jspolsky/Antenna2022/main/circuits/Receiver/receiver-1.0-bomandpos/Receiver-BOM.xlsx

Receiver-BOM
Comment | Designator | Footprint | Description | JLCPCB Part #
10uF | C1 C2 | 0805 | Unpolarized capacitor, small symbol | C15850
22uF | C3 | 0805 | Unpolarized capacitor, small symbol | C45783
0.1uF | C4 | 0402 | Unpolarized capacitor, small symbol | C1525
100uF 16V | C5 C6 C7 | 1210 | Unpolarized capacitor, small symbol | C90143
LED | D1 | 0805 | Light emitting diode | C84256
10K | R1 R2 R3 R5 | 0603 | Resistor, US symbol | C25804
1K | R4 | 0603 | Resistor, US symbol | C21190
20K | R6 R7 | 0603 | Resistor, US symbol | C4184
120 | R8 | 0603 | Resistor, US symbol | C22787
AMS1117-5.0 | U1 | SOT-223 | 1A Low Dropout regulator, positive, 5.0V fixed output, SOT-223 | C6187
MAX485E | U2 | SOIC-8 | Half duplex RS-485/RS-422, 2.5 Mbps, ±15kV electro-static discharge (ESD) protection, no slew-rate, no low-power shutdown, with receiver/driver enable, 32 receiver drive kapacitity, DIP-8 and SOIC-8 | C19738
