jspolsky/Antenna2022/main/circuits/CentralBrain/Printing Print.pdf

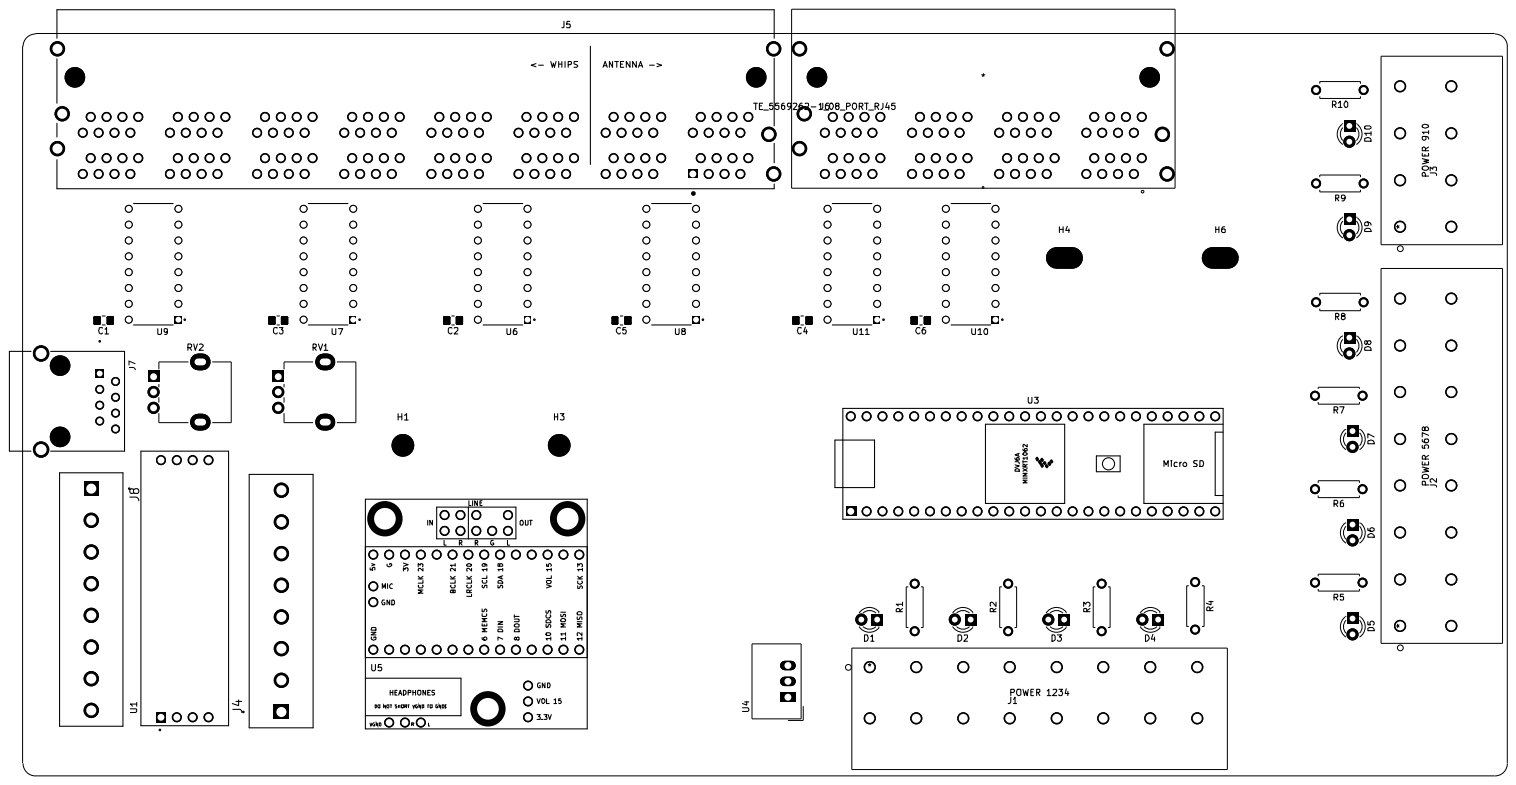
[picture p1: page 1]
