jspolsky/Antenna2022/main/circuits/CentralBrain/CentralBrain.kicad_pcb

## KiCad design main/circuits/CentralBrain/CentralBrain.kicad_pcb (2022-06-03)

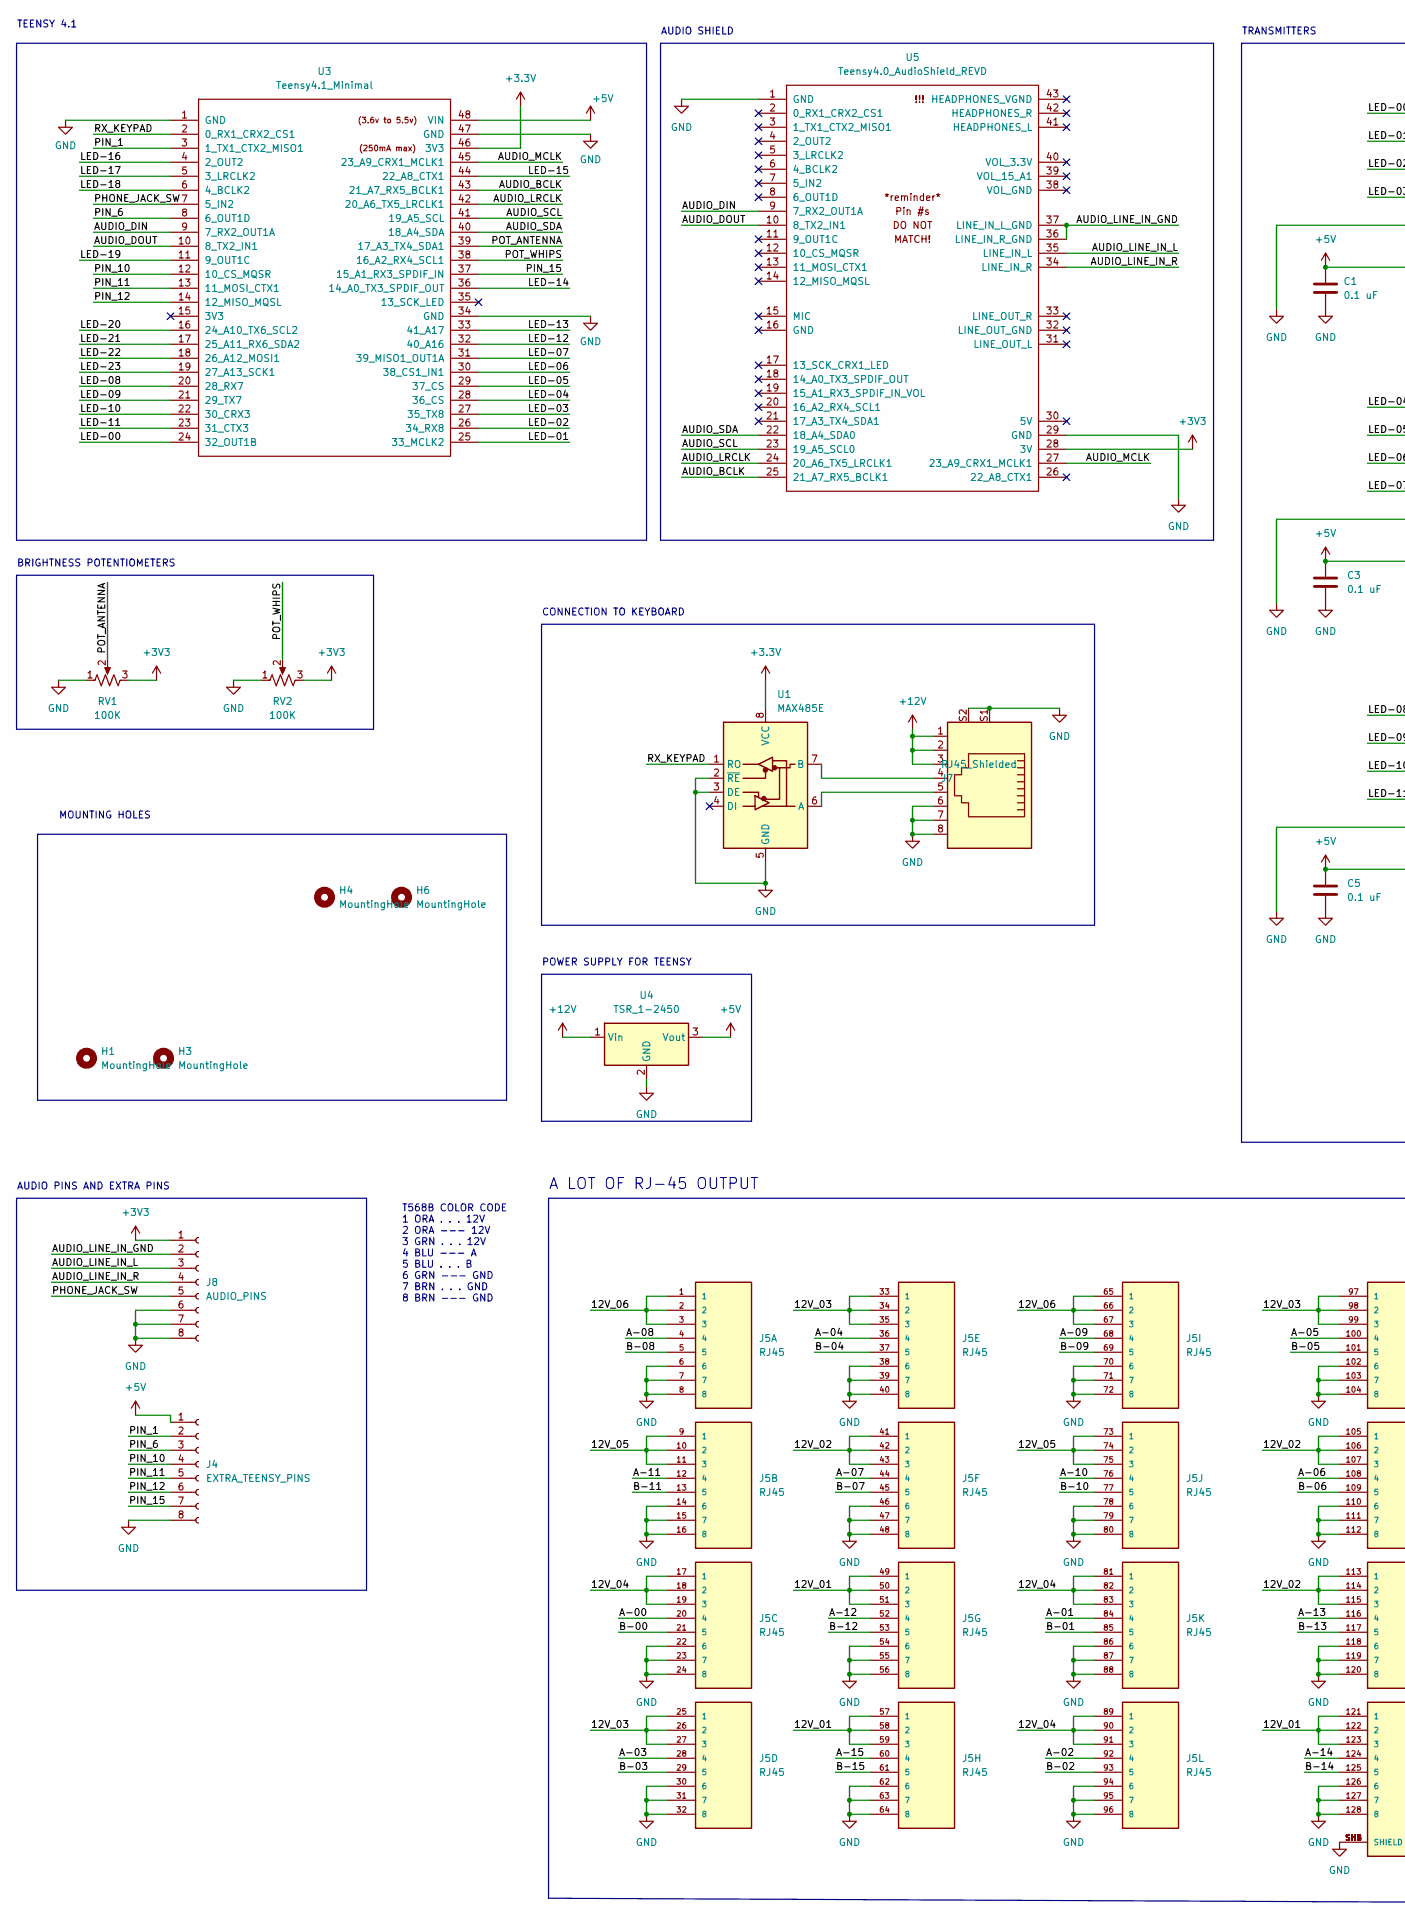
[picture p2: schematic CentralBrain.kicad_sch, part in row 1, column 1]

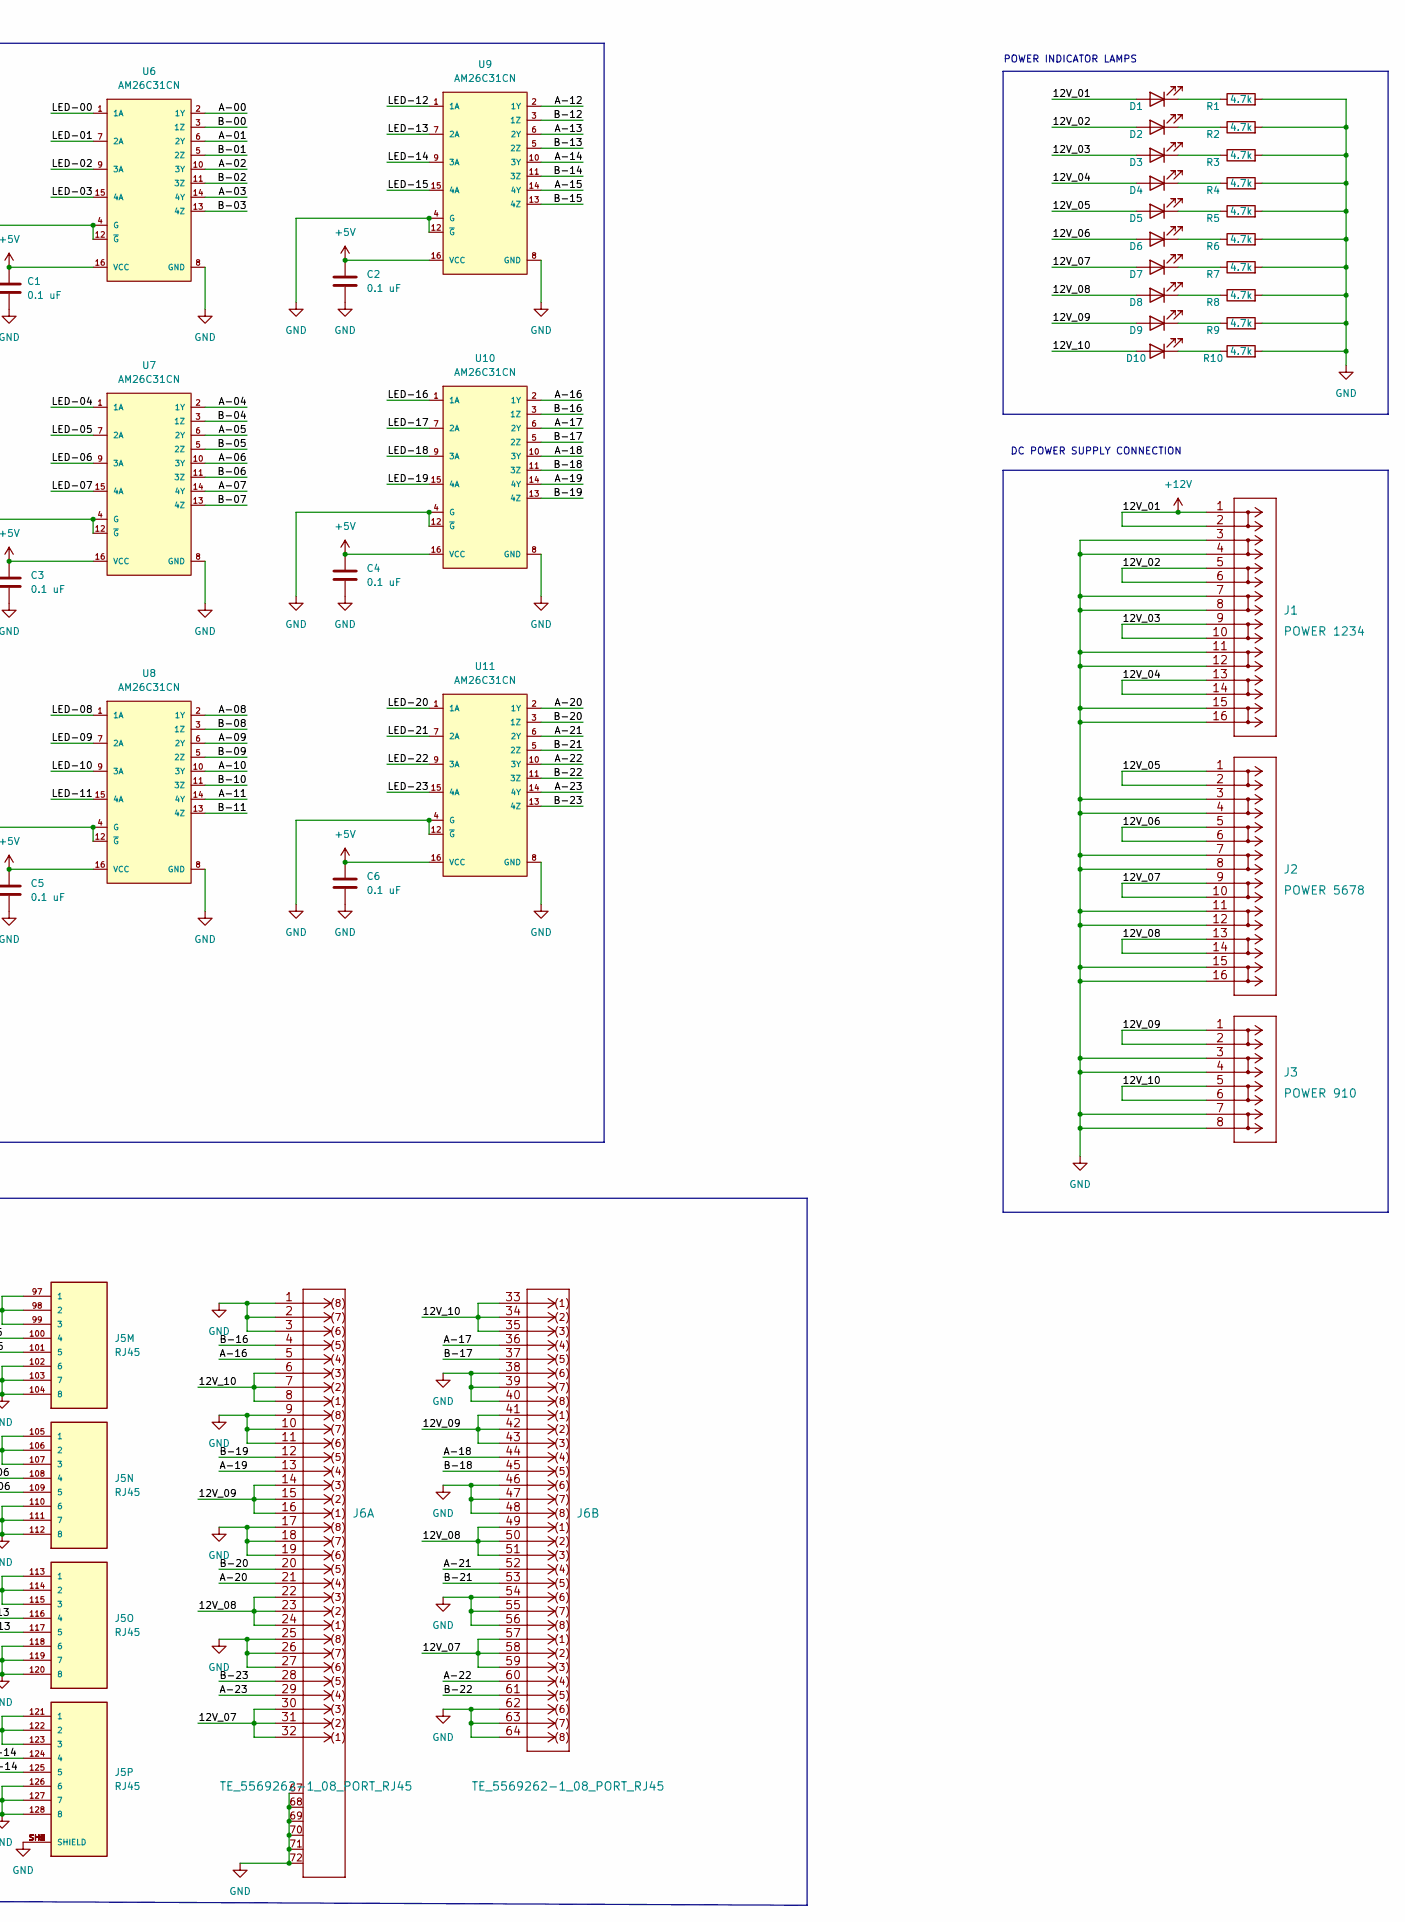
[picture p3: schematic CentralBrain.kicad_sch, part in row 1, column 2]

Parts:
C1, C2, C3, C4, C5, C6: 0.1 uF; C_0805_2012Metric_Pad1.18x1.45mm_HandSolder
D1, D2, D3, D4, D5, D6, D7, D8, D9, D10: LED; LED_D3.0mm
H1, H3, H4, H6: MountingHole; MountingHole_3.5mm
J1: POWER 1234; WAGO-2604-1308
J2: POWER 5678; WAGO-2604-1308
J3: POWER 910; WAGO-2604-1304
J4: EXTRA_TEENSY_PINS; CUI_term_block_8_TB004-508-08BE
J5: RJ45; TE_5569264-1_16_Port_RJ45
J6: TE_5569262-1_08_PORT_RJ45; TE_5569262-1_08_Port_RJ45
J7: RJ45_Shielded; RJ45-ASSMANN_A-2004-1-4-LP-N-R
J8: AUDIO_PINS; CUI_term_block_8_TB004-508-08BE
R1, R2, R3, R4, R5, R6, R7, R8, R9, R10: 4.7k; R_Axial_DIN0207_L6.3mm_D2.5mm_P7.62mm_Horizontal
RV1, RV2: 100K; Potentiometer_Alpha_RD901F-40-00D_Single_Vertical
U1: MAX485E; Max485-Module
U3: Teensy4.1_Minimal; Teensy41_Minimal
U4: TSR_1-2450; Converter_DCDC_TRACO_TSR-1_THT
U5: Teensy4.0_AudioShield_REVD; Teensy4.0_Audioshield_RevD
U6, U7, U8, U9, U10, U11: AM26C31CN; Rating Catalog; Supply VoltagesV 5

Connections:
+5V: C1.1, C2.1, C3.1, C4.1, C5.1, C6.1, J4.1, U3.48 (VIN), U4.3 (Vout), U6.16 (VCC), U7.16 (VCC), U8.16 (VCC), U9.16 (VCC), U10.16 (VCC), U11.16 (VCC)
+12V: D1.2 (A), J1.1, J1.2, J5.49 (1), J5.50 (2), J5.51 (3), J5.57 (1), J5.58 (2), J5.59 (3), J5.121 (1), J5.122 (2), J5.123 (3), J7.1, J7.2, J7.3, U4.1 (Vin)
/12V_02: D2.2 (A), J1.5, J1.6, J5.41 (1), J5.42 (2), J5.43 (3), J5.105 (1), J5.106 (2), J5.107 (3), J5.113 (1), J5.114 (2), J5.115 (3)
/12V_03: D3.2 (A), J1.9, J1.10, J5.25 (1), J5.26 (2), J5.27 (3), J5.33 (1), J5.34 (2), J5.35 (3), J5.97 (1), J5.98 (2), J5.99 (3)
/12V_04: D4.2 (A), J1.13, J1.14, J5.17 (1), J5.18 (2), J5.19 (3), J5.81 (1), J5.82 (2), J5.83 (3), J5.89 (1), J5.90 (2), J5.91 (3)
/12V_05: D5.2 (A), J2.1, J2.2, J5.9 (1), J5.10 (2), J5.11 (3), J5.73 (1), J5.74 (2), J5.75 (3)
/12V_06: D6.2 (A), J2.5, J2.6, J5.1, J5.2, J5.3, J5.65 (1), J5.66 (2), J5.67 (3)
/12V_07: D7.2 (A), J2.9, J2.10, J6.30, J6.31, J6.32, J6.57, J6.58, J6.59
/12V_08: D8.2 (A), J2.13, J2.14, J6.22, J6.23, J6.24, J6.49, J6.50, J6.51
/12V_09: D9.2 (A), J3.1, J3.2, J6.14, J6.15, J6.16, J6.41, J6.42, J6.43
/12V_10: D10.2 (A), J3.5, J3.6, J6.6, J6.7, J6.8, J6.33, J6.34, J6.35
/A-00: J5.20 (4), U6.2 (1Y)
/A-01: J5.84 (4), U6.6 (2Y)
/A-02: J5.92 (4), U6.10 (3Y)
/A-03: J5.28 (4), U6.14 (4Y)
/A-04: J5.36 (4), U7.2 (1Y)
/A-05: J5.100 (4), U7.6 (2Y)
/A-06: J5.108 (4), U7.10 (3Y)
/A-07: J5.44 (4), U7.14 (4Y)
/A-08: J5.4, U8.2 (1Y)
/A-09: J5.68 (4), U8.6 (2Y)
/A-10: J5.76 (4), U8.10 (3Y)
/A-11: J5.12 (4), U8.14 (4Y)
/A-12: J5.52 (4), U9.2 (1Y)
/A-13: J5.116 (4), U9.6 (2Y)
/A-14: J5.124 (4), U9.10 (3Y)
/A-15: J5.60 (4), U9.14 (4Y)
/A-16: J6.5, U10.2 (1Y)
/A-17: J6.36, U10.6 (2Y)
/A-18: J6.44, U10.10 (3Y)
/A-19: J6.13, U10.14 (4Y)
/A-20: J6.21, U11.2 (1Y)
/A-21: J6.52, U11.6 (2Y)
/A-22: J6.60, U11.10 (3Y)
/A-23: J6.29, U11.14 (4Y)
/AUDIO_BCLK: U3.43 (21_A7_RX5_BCLK1), U5.25 (21_A7_RX5_BCLK1)
/AUDIO_DIN: U3.9 (7_RX2_OUT1A), U5.9 (7_RX2_OUT1A)
/AUDIO_DOUT: U3.10 (8_TX2_IN1), U5.10 (8_TX2_IN1)
/AUDIO_LINE_IN_GND: J8.2, U5.36 (LINE_IN_R_GND), U5.37 (LINE_IN_L_GND)
/AUDIO_LINE_IN_L: J8.3, U5.35 (LINE_IN_L)
/AUDIO_LINE_IN_R: J8.4, U5.34 (LINE_IN_R)
/AUDIO_LRCLK: U3.42 (20_A6_TX5_LRCLK1), U5.24 (20_A6_TX5_LRCLK1)
/AUDIO_MCLK: U3.45 (23_A9_CRX1_MCLK1), U5.27 (23_A9_CRX1_MCLK1)
/AUDIO_SCL: U3.41 (19_A5_SCL), U5.23 (19_A5_SCL0)
/AUDIO_SDA: U3.40 (18_A4_SDA), U5.22 (18_A4_SDA0)
/B-00: J5.21 (5), U6.3 (1Z)
/B-01: J5.85 (5), U6.5 (2Z)
/B-02: J5.93 (5), U6.11 (3Z)
/B-03: J5.29 (5), U6.13 (4Z)
/B-04: J5.37 (5), U7.3 (1Z)
/B-05: J5.101 (5), U7.5 (2Z)
/B-06: J5.109 (5), U7.11 (3Z)
/B-07: J5.45 (5), U7.13 (4Z)
/B-08: J5.5, U8.3 (1Z)
/B-09: J5.69 (5), U8.5 (2Z)
/B-10: J5.77 (5), U8.11 (3Z)
/B-11: J5.13 (5), U8.13 (4Z)
/B-12: J5.53 (5), U9.3 (1Z)
/B-13: J5.117 (5), U9.5 (2Z)
/B-14: J5.125 (5), U9.11 (3Z)
/B-15: J5.61 (5), U9.13 (4Z)
/B-16: J6.4, U10.3 (1Z)
/B-17: J6.37, U10.5 (2Z)
/B-18: J6.45, U10.11 (3Z)
/B-19: J6.12, U10.13 (4Z)
/B-20: J6.20, U11.3 (1Z)
/B-21: J6.53, U11.5 (2Z)
/B-22: J6.61, U11.11 (3Z)
/B-23: J6.28, U11.13 (4Z)
/LED-00: U3.24 (32_OUT1B), U6.1 (1A)
/LED-01: U3.25 (33_MCLK2), U6.7 (2A)
/LED-02: U3.26 (34_RX8), U6.9 (3A)
/LED-03: U3.27 (35_TX8), U6.15 (4A)
/LED-04: U3.28 (36_CS), U7.1 (1A)
/LED-05: U3.29 (37_CS), U7.7 (2A)
/LED-06: U3.30 (38_CS1_IN1), U7.9 (3A)
/LED-07: U3.31 (39_MISO1_OUT1A), U7.15 (4A)
/LED-08: U3.20 (28_RX7), U8.1 (1A)
/LED-09: U3.21 (29_TX7), U8.7 (2A)
/LED-10: U3.22 (30_CRX3), U8.9 (3A)
/LED-11: U3.23 (31_CTX3), U8.15 (4A)
/LED-12: U3.32 (40_A16), U9.1 (1A)
/LED-13: U3.33 (41_A17), U9.7 (2A)
/LED-14: U3.36 (14_A0_TX3_SPDIF_OUT), U9.9 (3A)
/LED-15: U3.44 (22_A8_CTX1), U9.15 (4A)
/LED-16: U3.4 (2_OUT2), U10.1 (1A)
/LED-17: U3.5 (3_LRCLK2), U10.7 (2A)
/LED-18: U3.6 (4_BCLK2), U10.9 (3A)
/LED-19: U3.11 (9_OUT1C), U10.15 (4A)
/LED-20: U3.16 (24_A10_TX6_SCL2), U11.1 (1A)
/LED-21: U3.17 (25_A11_RX6_SDA2), U11.7 (2A)
/LED-22: U3.18 (26_A12_MOSI1), U11.9 (3A)
/LED-23: U3.19 (27_A13_SCK1), U11.15 (4A)
/PHONE_JACK_SW: J8.5, U3.7 (5_IN2)
/PIN_1: J4.2, U3.3 (1_TX1_CTX2_MISO1)
/PIN_6: J4.3, U3.8 (6_OUT1D)
/PIN_10: J4.4, U3.12 (10_CS_MQSR)
/PIN_11: J4.5, U3.13 (11_MOSI_CTX1)
/PIN_12: J4.6, U3.14 (12_MISO_MQSL)
/PIN_15: J4.7, U3.37 (15_A1_RX3_SPDIF_IN)
/POT_ANTENNA: RV1.2, U3.39 (17_A3_TX4_SDA1)
/POT_WHIPS: RV2.2, U3.38 (16_A2_RX4_SCL1)
/RX_KEYPAD: U1.1 (RO), U3.2 (0_RX1_CRX2_CS1)
GND: C1.2, C2.2, C3.2, C4.2, C5.2, C6.2, J1.3, J1.4, J1.7, J1.8, J1.11, J1.12, J1.15, J1.16, J2.3, J2.4, J2.7, J2.8, J2.11, J2.12, J2.15, J2.16, J3.3, J3.4, J3.7, J3.8, J4.8, J5.6, J5.7, J5.8, J5.14 (6), J5.15 (7), J5.16 (8), J5.22 (6), J5.23 (7), J5.24 (8), J5.30 (6), J5.31 (7), J5.32 (8), J5.38 (6), J5.39 (7), J5.40 (8), J5.46 (6), J5.47 (7), J5.48 (8), J5.54 (6), J5.55 (7), J5.56 (8), J5.62 (6), J5.63 (7), J5.64 (8), J5.70 (6), J5.71 (7), J5.72 (8), J5.78 (6), J5.79 (7), J5.80 (8), J5.86 (6), J5.87 (7), J5.88 (8), J5.94 (6), J5.95 (7), J5.96 (8), J5.102 (6), J5.103 (7), J5.104 (8), J5.110 (6), J5.111 (7), J5.112 (8), J5.118 (6), J5.119 (7), J5.120 (8), J5.126 (6), J5.127 (7), J5.128 (8), J5.SH1 (SHIELD), J5.SH2 (SHIELD), J5.SH3 (SHIELD), J5.SH4 (SHIELD), J5.SH5 (SHIELD), J5.SH6 (SHIELD), J6.1, J6.2, J6.3, J6.9, J6.10, J6.11, J6.17, J6.18, J6.19, J6.25, J6.26, J6.27, J6.38, J6.39, J6.40, J6.46, J6.47, J6.48, J6.54, J6.55, J6.56, J6.62, J6.63, J6.64, J6.67 (SH67), J6.68 (SH68), J6.69 (SH69), J6.70 (SH70), J6.71 (SH71), J6.72 (SH72), J7.6, J7.7, J7.8, J7.S1, J7.S2, J8.6, J8.7, J8.8, R1.2, R2.2, R3.2, R4.2, R5.2, R6.2, R7.2, R8.2, R9.2, R10.2, RV1.1, RV2.1, U1.2 (~RE), U1.3 (DE), U1.5 (GND), U3.1 (GND), U3.34 (GND), U3.47 (GND), U4.2 (GND), U5.1 (GND), U5.29 (GND), U6.4 (G), U6.8 (GND), U6.12 (~G), U7.4 (G), U7.8 (GND), U7.12 (~G), U8.4 (G), U8.8 (GND), U8.12 (~G), U9.4 (G), U9.8 (GND), U9.12 (~G), U10.4 (G), U10.8 (GND), U10.12 (~G), U11.4 (G), U11.8 (GND), U11.12 (~G)
unnamed: D1.1 (K), R1.1
unnamed: D2.1 (K), R2.1
unnamed: D3.1 (K), R3.1
unnamed: D4.1 (K), R4.1
unnamed: D5.1 (K), R5.1
unnamed: D6.1 (K), R6.1
unnamed: D7.1 (K), R7.1
unnamed: D8.1 (K), R8.1
unnamed: D9.1 (K), R9.1
unnamed: D10.1 (K), R10.1
unnamed: J7.4, U1.7 (B)
unnamed: J7.5, U1.6 (A)

Notes on the sheet:
MOUNTING HOLES
TRANSMITTERS
POWER INDICATOR LAMPS
T568B COLOR CODE 1 ORA . . . 12V 2 ORA --- 12V 3 GRN . . . 12V 4 BLU --- A 5 BLU . . . B 6 GRN --- GND 7 BRN . . . GND 8 BRN --- GND
CONNECTION TO KEYBOARD
POWER SUPPLY FOR TEENSY
A LOT OF RJ-45 OUTPUT
AUDIO PINS AND EXTRA PINS
TEENSY 4.1
DC POWER SUPPLY CONNECTION
BRIGHTNESS POTENTIOMETERS
AUDIO SHIELD

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
Board: 4 copper layers, 50 parts (0 on the bottom side), 117 nets, no tracks yet.
