jspolsky/Antenna2022/remote/circuits/AntennaRemoteButtons/AntennaRemoteButtons.kicad_pcb

## KiCad design remote/circuits/AntennaRemoteButtons/AntennaRemoteButtons.kicad_pcb (2022-05-21)

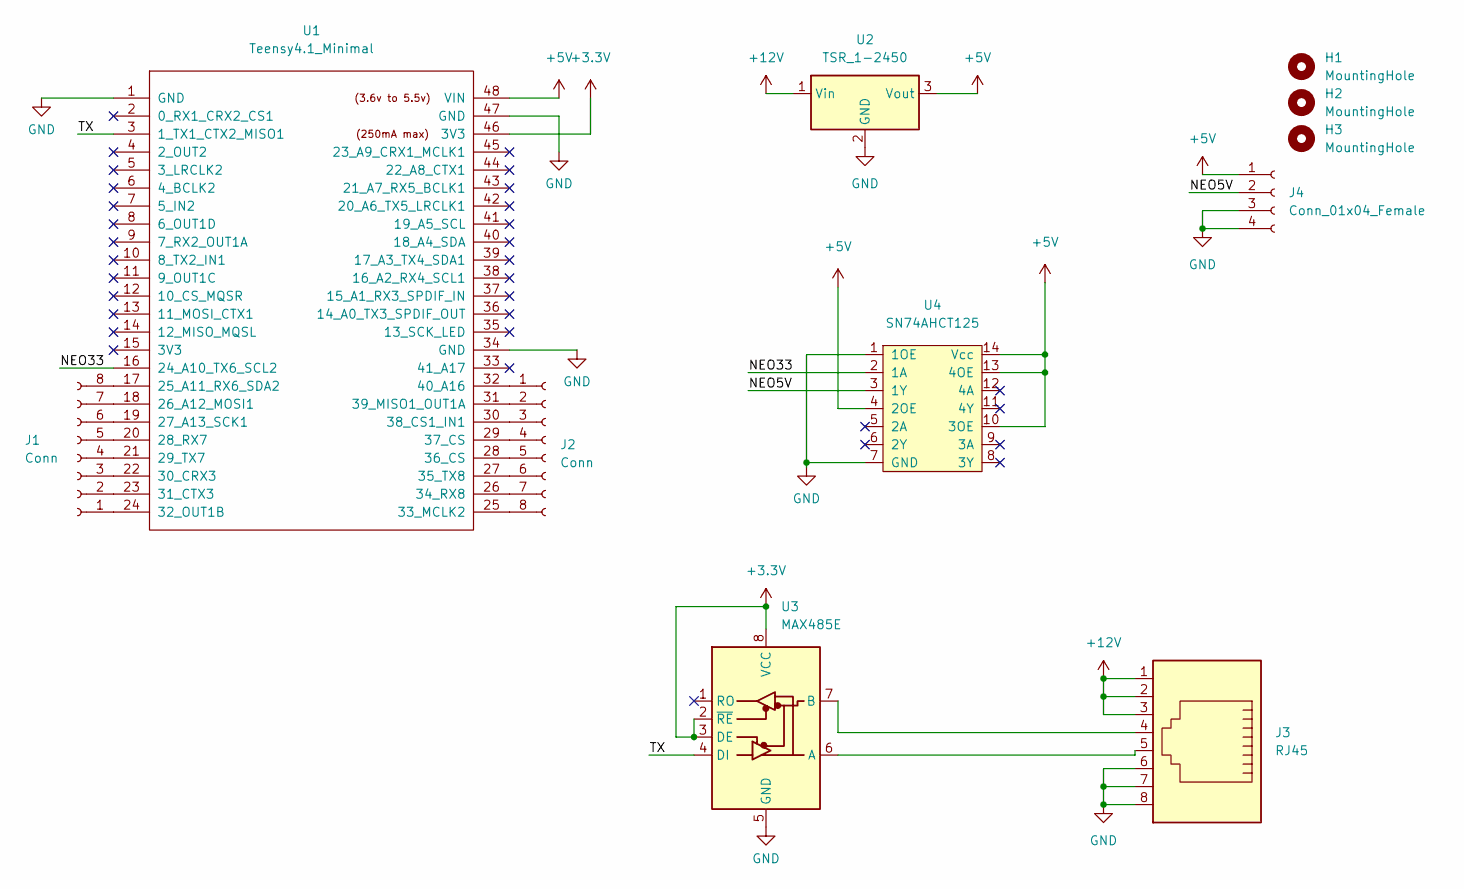
[picture p4: schematic AntennaRemoteButtons.kicad_sch]

Parts:
H1, H2, H3: MountingHole; MountingHole_5mm
J1, J2: Conn; CUI_term_block_8_TB004-508-08BE
J3: RJ45; RJ45-ASSMANN_A-2004-1-4-LP-N-R
J4: Conn_01x04_Female; CUI_term_block_4_CUI_TB004-508-04BE
U1: Teensy4.1_Minimal; Teensy41_Minimal
U2: TSR_1-2450; Converter_DCDC_TRACO_TSR-1_THT
U3: MAX485E; Max485-Module
U4: SN74AHCT125; SN74AHCT125N

Connections:
+3V3: U1.46 (3V3), U3.2 (~RE), U3.3 (DE), U3.8 (VCC)
+5V: J4.1, U1.48 (VIN), U2.3 (Vout), U4.4 (2OE), U4.10 (3OE), U4.13 (4OE), U4.14 (Vcc)
+12V: J3.1, J3.2, J3.3, U2.1 (Vin)
/NEO5V: J4.2, U4.3 (1Y)
/NEO33: U1.16 (24_A10_TX6_SCL2), U4.2 (1A)
/TX: U1.3 (1_TX1_CTX2_MISO1), U3.4 (DI)
GND: J3.6, J3.7, J3.8, J4.3, J4.4, U1.1 (GND), U1.34 (GND), U1.47 (GND), U2.2 (GND), U3.5 (GND), U4.1 (1OE), U4.7 (GND)
unnamed: J1.1, U1.24 (32_OUT1B)
unnamed: J1.2, U1.23 (31_CTX3)
unnamed: J1.3, U1.22 (30_CRX3)
unnamed: J1.4, U1.21 (29_TX7)
unnamed: J1.5, U1.20 (28_RX7)
unnamed: J1.6, U1.19 (27_A13_SCK1)
unnamed: J1.7, U1.18 (26_A12_MOSI1)
unnamed: J1.8, U1.17 (25_A11_RX6_SDA2)
unnamed: J2.1, U1.32 (40_A16)
unnamed: J2.2, U1.31 (39_MISO1_OUT1A)
unnamed: J2.3, U1.30 (38_CS1_IN1)
unnamed: J2.4, U1.29 (37_CS)
unnamed: J2.5, U1.28 (36_CS)
unnamed: J2.6, U1.27 (35_TX8)
unnamed: J2.7, U1.26 (34_RX8)
unnamed: J2.8, U1.25 (33_MCLK2)
unnamed: J3.4, U3.7 (B)
unnamed: J3.5, U3.6 (A)

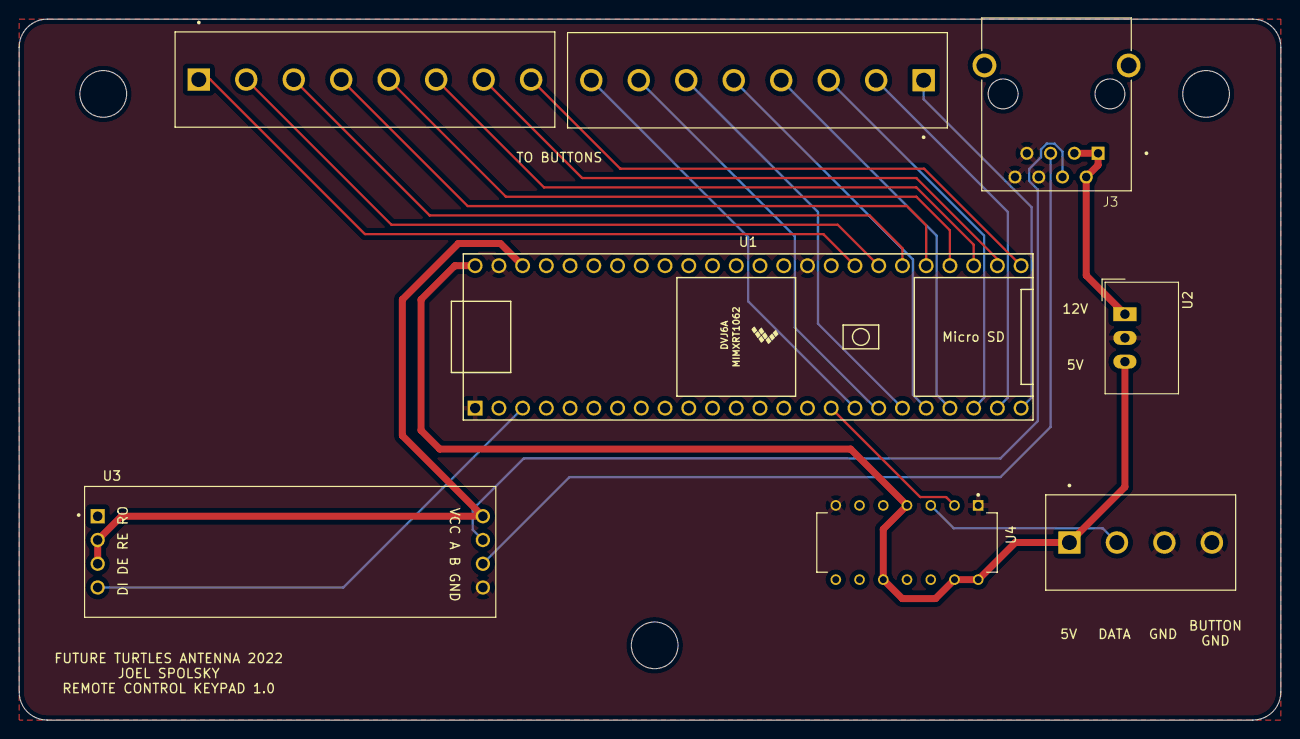
[picture p5: board AntennaRemoteButtons.kicad_pcb from above]

Board: 2 copper layers, 135.0 x 75.0 mm, 11 parts (0 on the bottom side), 25 nets.
