jspolsky/Antenna2022/main/circuits/Receiver/Receiver.kicad_pcb

## KiCad design main/circuits/Receiver/Receiver.kicad_pcb (2022-05-08)

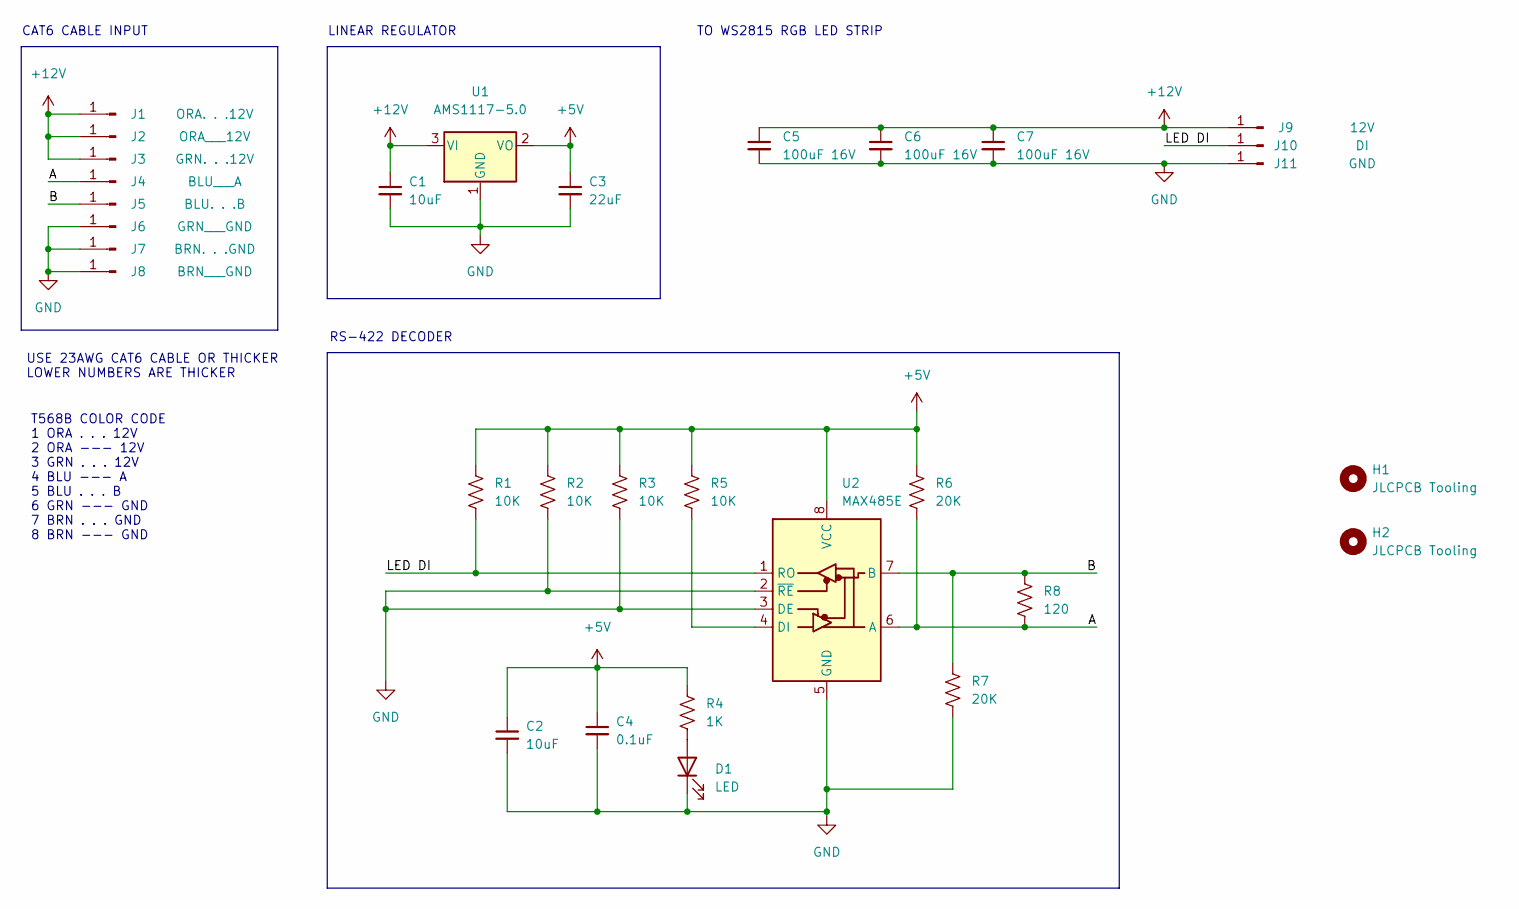
[picture p6: schematic Receiver.kicad_sch]

Parts:
C1, C2: 10uF; C_0805_2012Metric; JLCPCB C15850
C3: 22uF; C_0805_2012Metric; JLCPCB C45783
C4: 0.1uF; C_0402_1005Metric; JLCPCB C1525
C5, C6, C7: 100uF 16V; C_1210_3225Metric; JLCPCB C90143
D1: LED; LED_0805_2012Metric; JLCPCB C84256
H1, H2: JLCPCB Tooling; JCLPCB_Tooling_Hole
J1: ORA. . .12V; SolderWire-0.25sqmm_1x01_D0.65mm_OD1.7mm
J2: ORA___12V; SolderWire-0.25sqmm_1x01_D0.65mm_OD1.7mm
J3: GRN. . .12V; SolderWire-0.25sqmm_1x01_D0.65mm_OD1.7mm
J4: BLU___A; SolderWire-0.25sqmm_1x01_D0.65mm_OD1.7mm
J5: BLU. . .B; SolderWire-0.25sqmm_1x01_D0.65mm_OD1.7mm
J6: GRN___GND; SolderWire-0.25sqmm_1x01_D0.65mm_OD1.7mm
J7: BRN. . .GND; SolderWire-0.25sqmm_1x01_D0.65mm_OD1.7mm
J8: BRN___GND; SolderWire-0.25sqmm_1x01_D0.65mm_OD1.7mm
J9: 12V; SolderWire-1sqmm_1x01_D1.4mm_OD2.7mm
J10: DI; SolderWire-1sqmm_1x01_D1.4mm_OD2.7mm
J11: GND; SolderWire-1sqmm_1x01_D1.4mm_OD2.7mm
R1, R2, R3, R5: 10K; R_0603_1608Metric; JLCPCB C25804
R4: 1K; R_0603_1608Metric; JLCPCB C21190
R6, R7: 20K; R_0603_1608Metric; JLCPCB C4184
R8: 120; R_0603_1608Metric; JLCPCB C22787
U1: AMS1117-5.0; SOT-223-3_TabPin2; JLCPCB C6187
U2: MAX485E; SOIC-8_3.9x4.9mm_P1.27mm; JLCPCB C19738

Connections:
+5V: C2.1, C3.1, C4.1, R1.1, R2.1, R3.1, R4.1, R5.1, R6.1, U1.2 (VO), U2.8 (VCC)
+12V: C1.1, C5.1, C6.1, C7.1, J1.1, J2.1, J3.1, J9.1, U1.3 (VI)
/A: J4.1, R6.2, R8.2, U2.6 (A)
/B: J5.1, R7.1, R8.1, U2.7 (B)
/LED DI: J10.1, R1.2, U2.1 (RO)
GND: C1.2, C2.2, C3.2, C4.2, C5.2, C6.2, C7.2, D1.1 (K), J6.1, J7.1, J8.1, J11.1, R2.2, R3.2, R7.2, U1.1 (GND), U2.2 (~RE), U2.3 (DE), U2.5 (GND)
unnamed: D1.2 (A), R4.2
unnamed: R5.2, U2.4 (DI)

Notes on the sheet:
TO WS2815 RGB LED STRIP
CAT6 CABLE INPUT
LINEAR REGULATOR
T568B COLOR CODE 1 ORA . . . 12V 2 ORA --- 12V 3 GRN . . . 12V 4 BLU --- A 5 BLU . . . B 6 GRN --- GND 7 BRN . . . GND 8 BRN --- GND
RS-422 DECODER
USE 23AWG CAT6 CABLE OR THICKER LOWER NUMBERS ARE THICKER

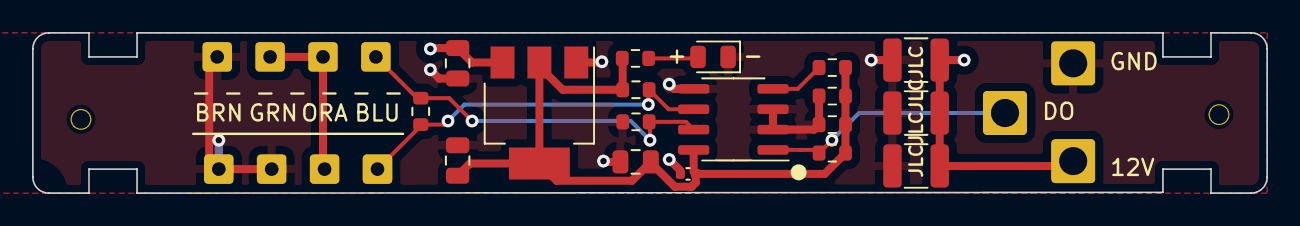
[picture p7: board Receiver.kicad_pcb from above]

Board: 4 copper layers, 77.0 x 10.0 mm, 31 parts (0 on the bottom side), 8 nets.
