jspolsky/Antenna2022/main/src/main.cpp

#include <Arduino.h>

#include "Util.h"
#include "brightness.h"
#include "controller.h"
#include "led.h"
#include "audioshow.h"

void setup()
{
  Util::setup();
  Brightness::setup();
  Led::setup();
  Audioshow::setup();
  Controller::setup();
}

void loop()
{

  static bool audioMode = false;
  static uint32_t lastAudioMillis = millis();

  Audioshow::loop();

  EVERY_N_MILLIS(100)
  {
    audioMode = Audioshow::jack_plugged_in();
    if (Audioshow::leftPeak > 0.01 || Audioshow::rightPeak > 0.01)
    {
      lastAudioMillis = millis();
    }
    if (millis() - lastAudioMillis > 3000L)
    {
      audioMode = false;
    }
  }

  uint8_t brightnessWhips, brightnessAntennas;
  Brightness::loop(&brightnessWhips, &brightnessAntennas);

  Controller::ButtonState *pbuttonState = Controller::loop();
  Led::loop(pbuttonState,
            brightnessWhips,
            brightnessAntennas,
            audioMode,
            Audioshow::leftPeak,
            Audioshow::rightPeak,
            Audioshow::fftBands);

  // static int fps = 0;
  // fps++;

  // EVERY_N_MILLIS(1000)
  // {
  //   dbgprintf("fps: %d\n", fps);
  //   fps = 0;
  // }
}
