jspolsky/Antenna2022/(commit log)

2022-05-06 Code for the Future Turtles antenna 2022
    [Receiver.kicad_pcb, Receiver.kicad_sch]
2022-05-07 first design of receiver PCB
    [Receiver.kicad_pcb, Receiver.kicad_sch]
2022-05-08 Use zipties for strain relief on cables
    [Receiver.kicad_pcb, Receiver.kicad_sch]
2022-05-08 1.0 sent to production
    [Receiver-BOM.csv, Receiver-BOM.xlsx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]
2022-05-19 don't commit kicad backups
2022-05-21 Moved into a subdirectory
    [Receiver-BOM.csv, Receiver-BOM.xlsx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]
2022-05-21 Adding remote control box as subdirectory
    [AntennaRemoteButtons-B_Cu.gbr, AntennaRemoteButtons-B_Mask.gbr, AntennaRemoteButtons-B_Paste.gbr, AntennaRemoteButtons-B_Silkscreen.gbr, AntennaRemoteButtons-Edge_Cuts.gbr, AntennaRemoteButtons-F_Cu.gbr, AntennaRemoteButtons-F_Mask.gbr, AntennaRemoteButtons-F_Paste.gbr]
2022-05-21 arg .DS_Store die
2022-05-23 no need for level shifters! thanks chuck!
    [CentralBrain.kicad_sch]
2022-06-02 started work on the central PCB
    [AntennaRemoteButtons.kicad_sch, CentralBrain.kicad_pcb, CentralBrain.kicad_sch]
2022-06-02 lots of work on pcb
    [CentralBrain.kicad_pcb, CentralBrain.kicad_sch]
2022-06-03 Mechanical design of PCB mostly done
    [CentralBrain.kicad_pcb, CentralBrain.kicad_sch]
2022-06-03 version 1.0 of board sent to mfr
    [CentralBrain-B_Cu.gbr, CentralBrain-B_Mask.gbr, CentralBrain-B_Paste.gbr, CentralBrain-B_Silkscreen.gbr, CentralBrain-Edge_Cuts.gbr, CentralBrain-F_Cu.gbr, CentralBrain-F_Mask.gbr, CentralBrain-F_Paste.gbr]
2022-07-13 brightness bracketing
2022-07-13 simplest possible utility functions for leds
2022-07-14 oops accidentally broke output
    [main.cpp]
2022-07-14 very rudimentary push button colors imma take a nap now
2022-07-22 solid color button interactivity done
2022-07-29 finished all the buttons!
2022-08-01 antenna will be to the left of the whips
2022-08-01 switch back to the main show if audio stops
2022-08-01 reasonable antenna option for music.
